polihedron/DIY-Reflow-Oven/README.md

# DIY-Reflow-Oven

Reflow Oven controler with buzzer, four reflow profiles with save and factory reset function.

https://youtu.be/2SATET4nPhk

I designed and 3D printed cover for a touch display, also I mounted mcu and other modules on a 3D printed holder.
3D files:

https://www.thingiverse.com/thing:4899782

I brought Severin TO-2068, 20L 1500W oven at second hand store.

BOM:
<ul>
<li>STM32F103 Development Board with mounting holes</li>
<li>5V 3.3V DC Logic Level Converter Bi-Directional Board Module</li>
<li>Nextion Basic 3,5" 480x320 NX4832T035</li>
<li>MAX6675 Thermocouple Module</li>
<li>Active buzzer with generator</li>
<li>5V power supply module HLK-PM01 3W</li>
<li>SSR-25DA Solid State Relay Module</li>
<li>Rocker Switch SPST, 10A/250VAC, Ø20,2mm</li>
<li>some M3 screws, wires with thermal shielding, connectors</li>
<li>Severin TO-2068 20L 1500W oven</li>
</ul>

based on awesome Vulcaman's project :
https://www.instructables.com/DIY-REFLOW-OVEN

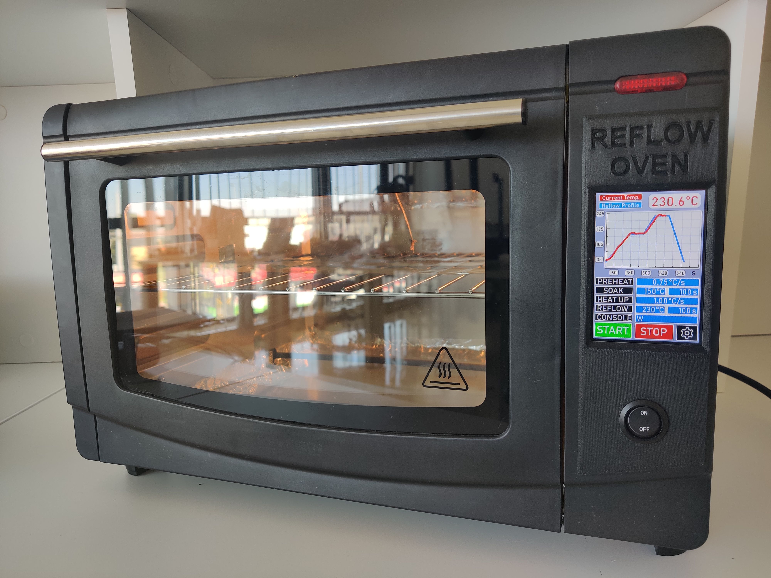
[picture p1: images/IMG_20210906_142324.jpg]


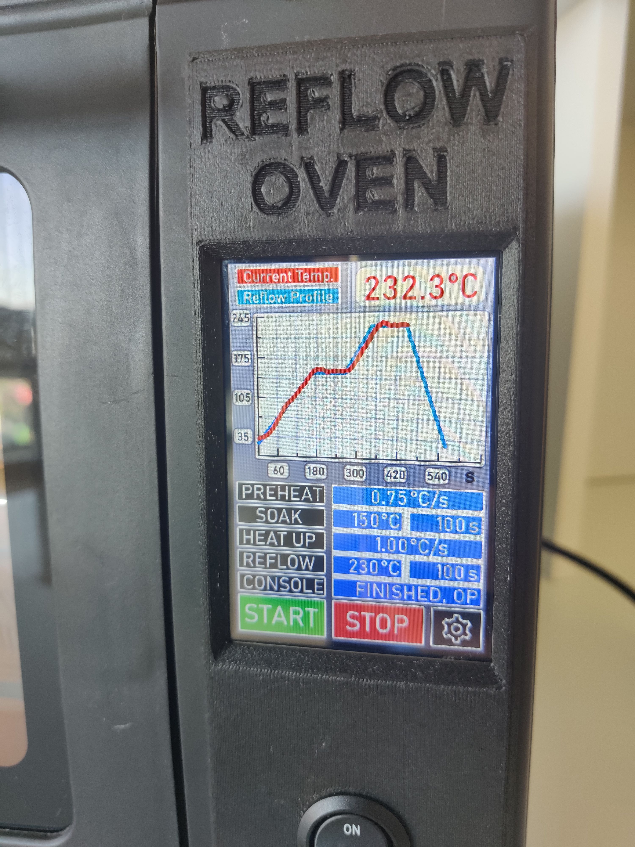
[picture p2: images/IMG_20210906_142349.jpg]


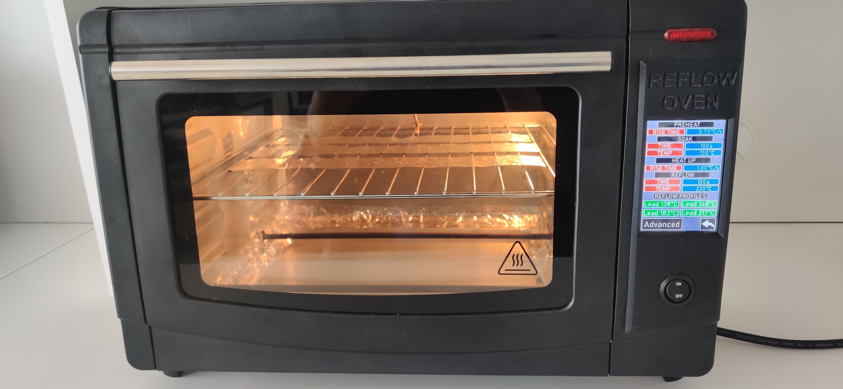
[picture p3: images/IMG_20210703_115956.jpg]






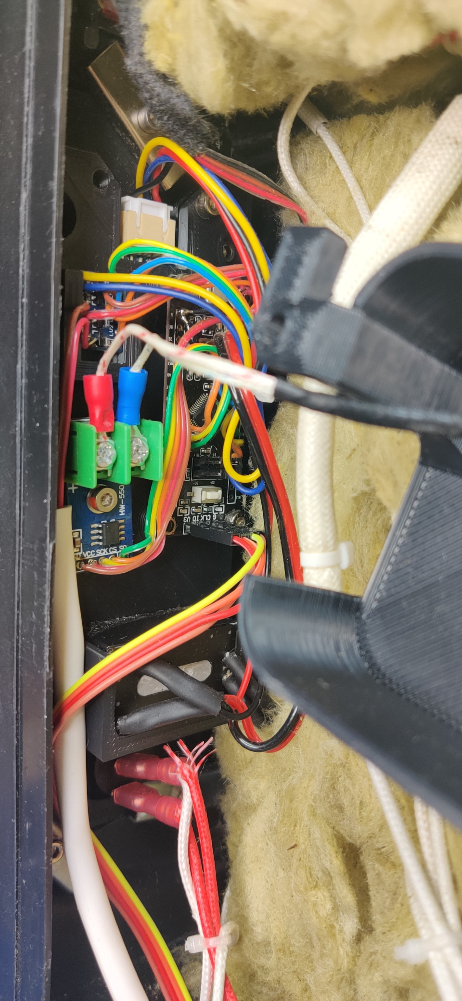
[picture p4: images/IMG_20210704_104110.jpg]


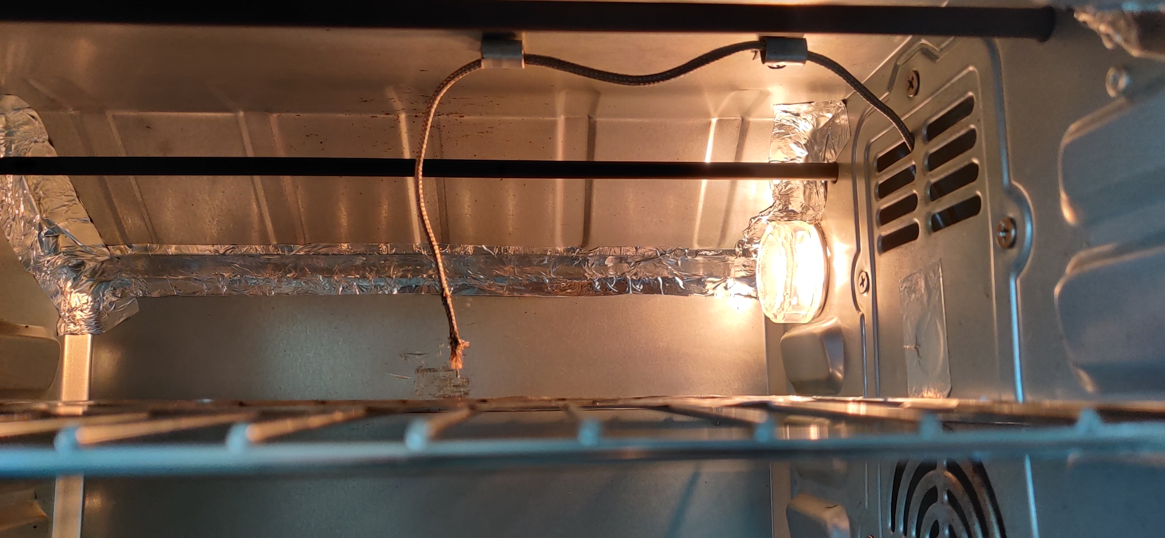
[picture p5: images/IMG_20210703_115900.jpg]


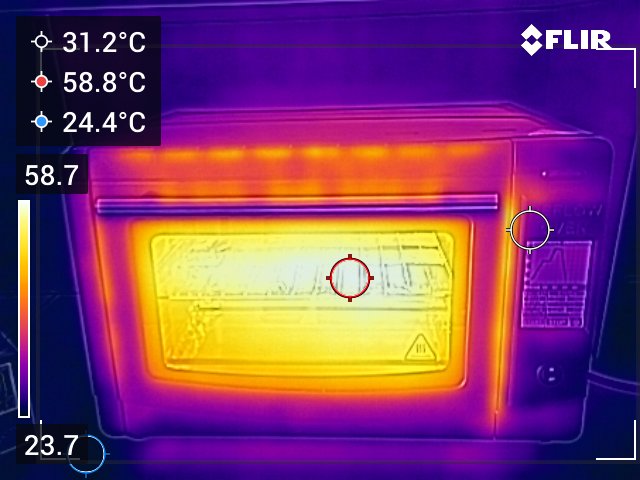
[picture p6: images/FLIR0053.jpg]
