polihedron/DIY-Reflow-Oven/nextion display/screens/0.png

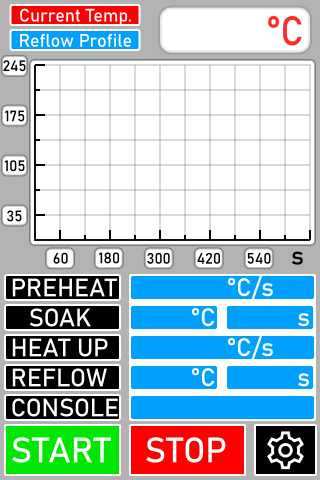
nextion display/screens/0.png
