polihedron/DIY-Reflow-Oven/nextion display/screens/1.png

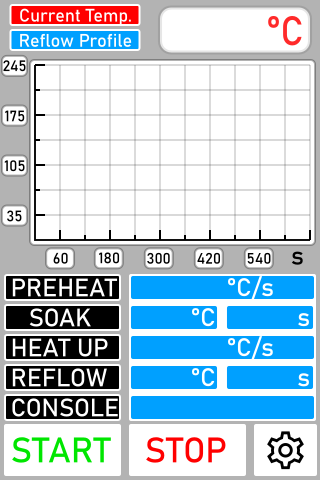
nextion display/screens/1.png
