polihedron/DIY-Reflow-Oven/nextion display/screens/2.png

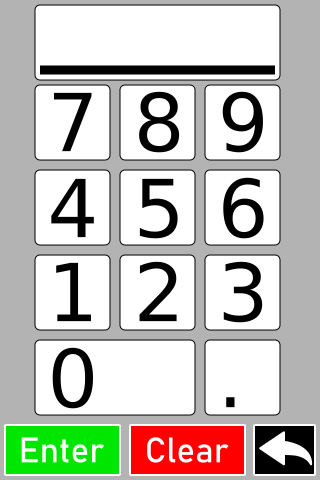
nextion display/screens/2.png
