polihedron/DIY-Reflow-Oven/nextion display/screens/3.png

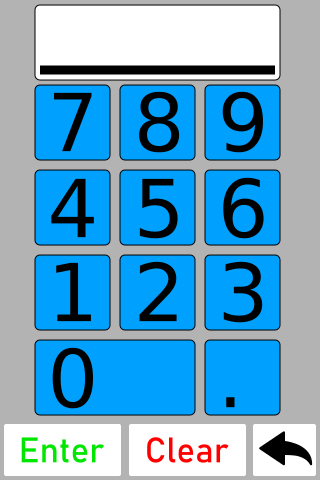
nextion display/screens/3.png
