polihedron/DIY-Reflow-Oven/nextion display/screens/4.png

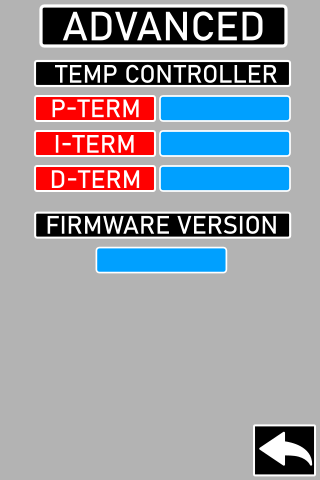
nextion display/screens/4.png
