polihedron/DIY-Reflow-Oven/nextion display/screens/5.png

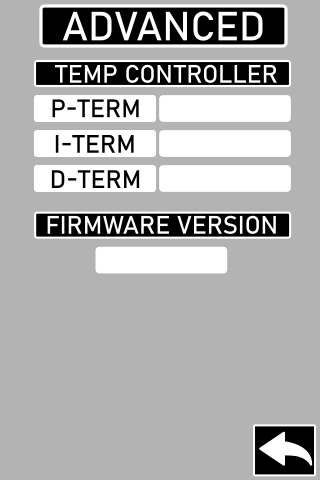
nextion display/screens/5.png
