polihedron/DIY-Reflow-Oven/nextion display/screens/6.png

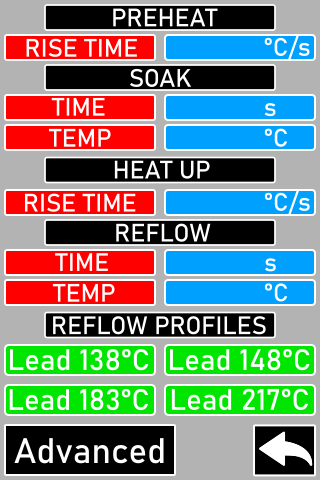
nextion display/screens/6.png
