polihedron/DIY-Reflow-Oven/nextion display/screens/7.png

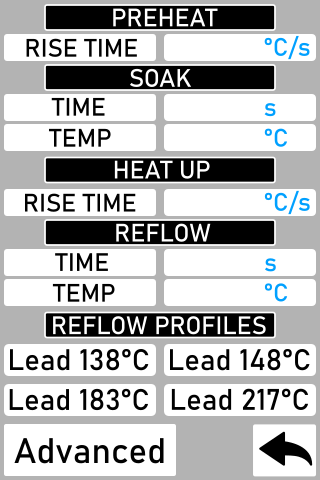
nextion display/screens/7.png
