polihedron/DIY-Reflow-Oven/(threads)

Thread 2 (2021-09-29):

On which port is connected the Buzzer ?

joelv1964, 2021-09-29:
Hi Polihedron, I have not yet started building my oven or its control electronics.  I really appreciate your idea of   adding a Buzzer, but can you tell which port of the STM32 it is connected to and if it is connected directly to it?  Thank you in advance for your answer.  Joel

polihedron, 2021-09-30:
Hi there, maybe soon I will update schematics to my mod.
Buzzer is connected via one of the 4 channel level shifter module mosfets to PA15.
But I belive it's not necessary if buzzer when active consume less than 20mA.
(Need to remove one of the resistors and cut the trace on the pcb.)
I just don't wanted to leave any mosfet useless.:)
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

joelv1964, 2021-09-30:
Great !  thank you so much.  I hadn't thought of using the second part of the shield ...
Have a good day !

daestx, 2024-08-05:
Maybe just an additional comment for The level shifter modification, when you would just like to use it as Mosfet to switch the Buzzer 5V. Here you can find a standard level shifter schematic:

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

So, in principle you need just to cut the LV connector and remove R4. LV1 pin needs to be connected

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

Closed 2021-09-30.

Thread 3 (2021-11-19):

No temperature number show up

botio, 2021-11-19:
I wired everything and flash the firmware to the blue pill and the NEXTION display, but there is not temperature number just show up empty UI... and I have tried to find out for two days... even tried another blue pill... please help me!

polihedron, 2021-11-19:
It's hard to guess,
- make sure that connections are ok,
- with USB to UART converter check that nextion can read and send data,
- the same with bluepill, connect converter to bluepill and try to send commands via terminal.
- replace level shifter module
- switch rx and tx
- etc.

botio, 2021-11-19:
Thank you so much, I found the solution is to clean the flash first and reprogram it with v1.1 bin file. Everything works fine now. next step is adding fan ... or not.

polihedron, 2021-11-20:
Adding fan can be tricky, because air temperature is quite high, easier and probably cheaper method is to look for convection oven, or find some replacement fan of the convection oven (they have metal sheet blades).

Closed 2021-11-19.

Thread 4 (2021-11-20):

how to add "reflow profiles" into 1.1 firmware

botio, 2021-11-20:
seems like only the original 1.1 firmware working for me to read the temp number, but I do really want to add the reflow profiles from "DIY-Reflow_Oven" like "lead 183" and other profiles. Could you let me know which file or which parts I should add to the 1.1 sources and build for adding this function? thank you so much.

polihedron, 2021-11-20:
This repo contains my changes, if you look closer you will find commits and changes in code of the first version 1.1.
To make mod complete you will need to flash:
- bluepill using binary version 1.2,
- nextion display with mod
recent hmi and bin files are on releases page.
If you want to build and flash from sources then just download and open project in STM32CubeIDE. Names of the folders are self-explanatory.

botio, 2021-11-20:
Hi, after tried the release 1.2 even with the bin file or the one I build from sources code, it’s not working with the mod display. The tricky part is the mod display(1.2) is only working with the original 1.1 blue pull for me. I don’t understand why and how …

polihedron, 2021-11-20:
I think you're doing something wrong. If you're using v1.2 hmi file with stm v1.1 binary, then you got chart temperature and time incorrect. Open project again in STM32CubeIDE, switch from release to debug and try to compile, then flash with full erase. It's crucial to use the same binary versions for nextion and bluepill.
Buzzer is just an output, no need to wire for the first run, especially when you're flashing blue pill stm32 with 1.1 version.
(v1.1 has no code for buzzer)

botio, 2021-11-20:
this drives me crazy... I check all the wires again, and everything is exactly like the diagram u provide... but just can't get the stm v1.2 run with mod display....

polihedron, 2021-11-20:
I have no idea why you have issues with project, already checked two stm32 bluepill boards, it's working like a charm.
Like I wrote this is quite simple mod, copy/paste code from main.c and main.h files to version 1.1, add output to PA15, or comment lines with buzzer, compile and flash, if no errors or warnings, you will get my mod version 1.2.

botio, 2021-11-21:
The only thing I think may cause problem is my levelshifter 4ch, which may not like urs. Otherwise, there is no way display can't get number from bluebill. And thank you so much for your help.

Closed 2021-11-21.

Thread 5 (2021-11-25):

Does anyone else make this working on bluepill??

botio, 2021-11-25:
okay, so I have bought the whole brand new components and did the 1.2 hmi and stm again and again. But the wired thing it's still not working (no number or profile line shows on the nextion screen) ... so I'm wondering it may not working with bluepill ... is there anyone make this working with bluepill?? thanks. BTW, the whole set is working with 1.1 original...

polihedron, 2021-11-25:
I think you should try harder. I got no problems with brand new stm32 blue pill dev board.
I was not using STM32CubeIDE, just st-link utility, and flash fw with last release bin file.
Try to debug, put some efford, check why your bluepill is not sending data to nextion display instead of opening and closing issues.

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
.

botio, 2021-11-26:
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
I tried really hard, and the reason I post this issue is to see if anyone else got the same problem like me… I’m wondering my bluepill if fake and the flash size is not real, so I order a blackpill on the way now. If opening issue bothers u, I won’t do this again just didn’t know where else I can ask. Thank u

botio, 2021-11-26:
Btw… why ur blue pill connect to the PC in the photo? Thanks

polihedron, 2021-11-26:
I'm using cheap clone bluepill.
Do you have USB to UART converter, and do you know how to use it?
You still didn't provide any more info about your issue.
Magic crystal ball is quite expensive these days, and it's hard to get one in good condition.
Like I wrote before, can you check that bluepill is working?

After power on bluepill is sending reflow profile chart data, and then constantly temperature readings together with state "IDLE", baudrate is 38400.
Remember that stm32 bluepill is using 3.3V logic, so level shifter is needed, or set usb coverter jumper to proper voltage.

To findout that Nextion display can recieve data via UART you need to connect display to UART converter, run Nextion Editor, then open v1.2 hmi file, from menu choose: Debug, switch from Send command to "Simulator", to "Nextion device", connect on your com port, and then at the Instruction Input Area as an string send:
page 3
if you done this right, and communication is working, then you should see on nextion display reflow parameters menu.
to come back to main screen send:
page 0

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

BTW nice printouts, what material did you choose?

botio, 2021-11-26:
thanks, I was watching STM32 IDE tutorial right now, since this is kinda my first STM32 project, I'm still learning. But yeah, thank you for the detail info for how to debug, and I'll going to try.

"USB to UART converter" is the st-link ?? I do have one that's how to connect to CubeIDE.

I did print out the panel with PLA .... bc I will only do reflow under 183C, is it okay? or should I print with ABS?

polihedron, 2021-11-26:
Nope, st-link isn't usb to uart converter, you should buy one, instead of buying blue pills. Try to find any on ftdi chip (ft232), but any other should work with installed drivers.
Regarding to PLA, depends on how long time will be hot oven enclosure, and how close printed parts will be.
I printed mine in ASA, but after some time decided to print in PA12 CF15, because I'm using oven quite often.

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

botio, 2021-11-26:
Uart converter, I think I found one with ft232. and after connect with bluepill to arduino via UART. I didn't see any info showed with baudrate 38400...  still trying, switch rx tx ... and going on...

polihedron, 2021-11-26:
Then there is no temperature readings, or no reflow parameters saved at start.
Flash bluepill with v1.1 fw, on the nextion display go to advanced menu where are pid settings, you can change something, but it's not mandatory, comeback to main screen.
Check btw is the temperature reading visible on the screen.
Relfow parameters should be saved now in flash memory.
Flash again bluepill with 1.2 fw, but do not erase, just flash and verify.
If still issue, then only debug left.

botio, 2021-12-05:
wait.... so u fixed it???

polihedron, 2021-12-06:
Yes, you pointed issue, I missed in code first run function witch is saving configuration parameters. If someone used old firmware version v1.1 and saved parameters to flash memory, then checked my mod flashing stm32bluepill without full memory erase - my mod was working (somehow).
So if flash memeory was erased, wihout these configuration parameters at start, stm32bluepill was unable to calculate and then send reflow curve to nextion display.
I belive that was your case, but if issue still persist, then you have hardware problem to solve, use UART to USB converter to confirm that both modules: stm32bluepill and nextion display are receiving and sending data.

My code is messy needs some general refactoring, but works.. in some circumstances ;)
Feel free to modify code and fix issues if you find any.

polihedron, 2022-07-11:
@botio did you manage make this project working?

daestx, 2024-08-11:
So, I used a bluepill board and it worked out of the box.
I compiled the code with STM32CubeIDE and flashed it with a segger j-link EDU

Closed 2022-07-18.

Thread 6 (2022-01-10):

Keypad is not reacted

VCO34, 2022-01-10:
Hello, i was testing release version 1.3, but it dont has implemented support Keypad for update profile. Is it possible ? I visited to your code and e.g. command from keypad "p1b01" is not find.  Do you have going to plan implemented ?

polihedron, 2022-01-11:
I'm not sure what you're asking for.
p1b01 is button on page 1 - keypad, for page1 is HandleKeyPad() function and that is the same as initial release.
No need to code every keypad buttton. Just the special ones like enter, or clear. Keypad is working in v1.3 just as in yt video.
To switch - update, or save reflow profile you will need p3b08 ... p3b11 buttons, saving is when you hold them for more than 3000ms, so nextion display sends commands: p3bs0 ... p2bs3.

VCO34, 2022-01-11:
Hi, problem is in release file Reflow_Oven_STM32.v1.3.bin. If i upload  file with STM32CubeProgrammer, keypad is not function. If i compile source code and upload. Keypad is fuction correct. :)

polihedron, 2022-01-12:
That's odd, both binary files: debug and release are working on my stm32 dev board.
At first run did you have blue line reflow profile, and temperature readings on the nextion display?
What stm32 dev board do you have?
Did you full erase memory before flashing?

VCO34, 2022-01-13:
Hi, first run was not problem. Temperature showed correct, by push START button started draw red line chart. I am using BluePill ARM STM32 STM32F103C8, maybe china clone. My setting CubeProbrammer - Skip flash erase before programming (OFF), Verify programming (ON), Run after programming (ON). For programing i used STlink V3 programmer.

VCO34, 2022-01-13:
Very interesting problem. If I generate RS *.bin file with my STMCubeIDE. I upload file with CubeProgrammer. Keypad is not function. If I build and upload with STMCubeIDE, keypad is function. I am sending my RS file for test for you.

https://uloz.to/tamhle/FdbzSdNu88f6/name/Nahrano-13-1-2022-v-10-29-47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

polihedron, 2022-01-16:
I think I fixed this, quite interesting case, because of compilation optimalization level: Optimalize for size -Os, and and any other than debug and none.
UART_Recieved_Flag were lost somewhere,"volatile" at the variable fixed this.

PricelessToolkit, 2022-01-16:
Thanks!!

Closed 2022-01-11.

Thread 7 (2022-04-23):

Cold junction compensation?

PricelessToolkit, 2022-04-23:
Hi @polihedron,
I want to do the same project and I have two questions if it's not difficult help me figure it out.

1. maybe you checked the whole area in the oven is heated evenly? I bought T-962A+ it does not warm up evenly, Cannot be used without full modification.
2. In the future do you have plans to implement cold junction compensation with a  1-wire temp sensor like DS18B20?
3. Thanks

polihedron, 2022-04-24:
Hi there, to be honest I didn't bother is whole area in the oven is heated evenly, because there is still quite wide temperature offset for each reflow stage in solder paste datasheet. I checked two large pcbs (171mmx131) for power leds and I'm happy with results:
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

Have you checked MAX6675 datasheet? 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

Kind Regards

polihedron, 2022-05-06:
@PricelessToolkit do you have any other questions regarding cold-junction compensation issue?

PricelessToolkit, 2022-05-06:
@polihedron No, Thank you very much for responding.

polihedron, 2022-05-07:
@PricelessToolkit ok,
good luck with project and T-962A+ mod.

Closed 2022-05-07.

Thread 8 (2022-05-22):

Limit Max Temp 240°C

PricelessToolkit, 2022-05-22:
Hi, I can't increase the temperature above 240°C, Is there a hardcoded limit in the code, or its a bug?

In my case thermocouple measuring air temperature (with this approach there is no PCB temperature overshoot )the difference between air temperature and PCB is 5-6°C and therefore wanted to raise the temperature ~10°C.

PS: my 8Liter and 800W

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

polihedron, 2022-05-22:
@PricelessToolkit
Yes, there are input limits,
look inside the HandleGui() in main.c if you want to modify them as desired.
btw. nice front panel printout.

PricelessToolkit, 2022-05-22:
Thanks i faund it
"if (Output > 240) Output = 240;"

I think 245°C is enught for me. Can you explain me how to compile this Project.  Thank you very match!!

polihedron, 2022-05-23:
@PricelessToolkit, there are many ways to compile project, look for tutorials on internet.
Easiest way is open project in STM32CubeIDE and use 'compile' button..
good luck!

PricelessToolkit, 2022-05-23:
If I succeed, I'll post the result. Thanks!!

PricelessToolkit, 2022-05-23:
all works great,  also changed the HMI file.
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
thanks for your help

Closed 2022-05-23.

Thread 9 (2022-09-24):

Temp (t0) returns zero

planestoner, 2022-09-24:
**'temp' & t0 returns/displays zero (0.0)** on Nextion display and serial logging when flashing release and debug Reflow_Oven_STM32.bin

Multiple resolutions attempted to no avail including:
- Multiple power supplies (inc PC 400w PSU) to 5V and 3.3V
- Grounding of thermocouple shield
- Connecting STM32 directly to MAX6675 module and FT232RL FTDI module
- Testing another MAX6675 module
- Testing MAX6675 module on ESP32 (confirmed as working)
- Testing separate STM32F103 module
- Confirmed genuine STM32F103 using [Blue Pill Diagnostics project](https://mecrisp-stellaris-folkdoc.sourceforge.io/bluepill-diagnostics-v1.6.html)
- Analysed SPI lines with logic analyser and Pulseview
- Debugged Reflow_Oven_STM32.bin with ST-Link V2

When testing MAX6675 module with ESP32 it shows this:
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

When testing MAX6675 module with STM32F103 with Reflow_Oven_STM32.bin it shows this:
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

When debugging Reflow_Oven_STM32.bin with ST-Link V2  'temp' reads 0.0 when setting breakpoint on main.c line 793
```
		if (ReflowEnable == 1) {
```
However, 'temp' reads correctly when setting breakpoint on main.c after line 779 (after HAL_SPI_Receive)
```
		//Thermocouple alle 500ms auslesen:
		HAL_GPIO_WritePin(CS_GPIO_Port, CS_Pin, 0);      // 778
		HAL_SPI_Receive(&hspi1, data, 2, 100);           // 779
// Breakpoint
		HAL_GPIO_WritePin(CS_GPIO_Port, CS_Pin, 1);      // 780
```

When adding ```HAL_Delay(1);``` the code runs fine (with CS being pulled low horribly long), although, this is merely a work around and not a proper fix. I tried the delay in a few placed but this seems the best location for the workaround.
```
		//Thermocouple alle 500ms auslesen:
		HAL_GPIO_WritePin(CS_GPIO_Port, CS_Pin, 0);
		HAL_SPI_Receive(&hspi1, data, 2, 100);
		HAL_Delay(1);
		HAL_GPIO_WritePin(CS_GPIO_Port, CS_Pin, 1);
```

I considered raising a PR with the added delay but STM32 documentation doesn't include it nor does the MAX6675 datasheet. I'm not entirely sure this is an issue with the code, however, raising an issue as there are no doubt better minds than mine out there with a lot more experience. Also raising this for those in the future that run into this problem. Suggested possible causes:
- External crystal is a little fast
- SPI isn't setup correctly
- Something I haven't thought of (sorry I'm not well versed in the STM32).

polihedron, 2022-09-25:
thanks @planestoner, I admire your effort,
can you check what HAL_SPI_Receive() returns?
like:
HAL_StatusTypeDef errcode;
errcode = HAL_SPI_Receive(&hspi1, data, 2, 100);

Data from logic analyser seems to be fine in both cases:
#0321 reads 1100100 = 100dec *0.249 = 24.9C
#02D1 reads 1011010 = 90dec *0.249 = 22.4C

planestoner, 2022-09-26:
Thanks @polihedron for the reply. I've tried a few things and long story short I only get a good temp reading is the the inclusion of the hal_delay.

With ``` errcode = HAL_SPI_Receive(&hspi1, data, 1, 100); ``` and without delay I get these:
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

Setting ``` HAL_SPI_Receive(&hspi1, data, 1, 100); ``` seems to pull CS low for too short a time unless I introduce the delay and I get this  (errcode returns HAL_OK):
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

polihedron, 2022-09-26:
@planestoner
maybe spi is not ready then?

this code is a bit messy, and since my oven is working I don't have time and motivation for general refactoring.
so my another idea is to use library like:
https://github.com/ipa64/MAX6675-STM32-library-using-HAL

or check this:
` while ((HAL_SPI_GetState(hspi) != HAL_SPI_STATE_READY));`
put it before spi read.

planestoner, 2022-09-26:
I'm in the same boat regarding time and since my device works with the included delay I'm happy for you to close the issue.

If the code is the issue maybe we or someone will be able to spot it and re-open this issue. In the mean time the work around is to add in the delay.

Gokhanto, 2023-06-22:
@planestoner @polihedron
Hi Guys, i havent seen the issue here, i managed to buy all the parts and assemblev all the parts and noticed that the temperature reading is stable 0.0 Degrees. Can you please help me?  Can i use your bin file with the delay to fix my issue?

polihedron, 2023-06-23:
Hi there @Gokhanto
- open reflow oven stm32 project directory in STM32CubeIDE (or simply open .project file)
- add delay in main.c like @planestoner.
- click green button Run.. and then flash your stm32 bluepill.
good luck.

Gokhanto, 2023-06-23:
@polihedron
Thanks for the quick reply. I started to open the project file but the main.c document looked like a chineese document with weird sysmbols, not much to read.  But i managed to open the main.c file by it self and added the delay, but im getting an error "Failed to connect to device., Failed to start GDB server." [https://ibb.co/fqqc4yp](url)

polihedron, 2023-06-24:
@Gokhanto I'm sorry I can't help you with this, please read or watch some tutorials on internet how to flash stm32 bluepill with st-link.

planestoner, 2023-06-25:
I've checked and sadly I don't have any of those files any more. Sorry

Gokhanto, 2023-07-10:
@planestoner @polihedron
Just for your information, i found out that the stm32, i had were a clone, so i ordered a new one and it solved all the problems, everything works.

Closed 2023-06-25.

Thread 10 (2023-03-28):

Not working.......

Cabinfourus, 2023-03-28:
I have built this thing and followed the guide with my build. I used the instructibles guide as the tutorial.
I never could get mine to work. The Nextion display has the correct screens but the STM32 code never worked at all. I loaded the .bin file correctly (i think). I am not sure how to go in and rework the source code and program the STM32. Is there a guide to this?

polihedron, 2023-03-29:
Hi there @Cabinfourus,
you're wasting your time (and mine also) with that kind of feedback: "not working...." or "never worked at all"
I can recommend you something like:
- check wiring again,
- have you tried turning off and on again?
- that's odd my is working.....

Please put some efford to figure out yours build issue, I don't have crystal ball.
No time bandwidth here and motivation to help you when you are so lazy to find and read how to debug or how to flash stm32.

Kind Regards

Closed 2023-03-29.

Thread 11 (2023-09-27):

KeyPad and Profiles not working

hellzakk, 2023-09-27:
Hi, i open the Reflow.mod.HMI project file with Nextion Editor v. 1.65.1 and I can start debugging and navigate between pages but the keypad does not work and clicking on the welding profiles does not make them visible on the first page.
I get the same result even loading the project on the display (including the non-mod / original).
Any suggestions? Thank you.

EDIT:
Button 1 Touch Release Event code is print "p1b01" but it's now deprecated [https://nextion.tech/instruction-set/](url)
Maybe the new display with updated firmware are no longer compatible with the "old" code?

polihedron, 2023-09-28:
Hi there,
- try to downgrade your nextion editor,

- use prints with "0" - all parameter, or number of chars:
`prints "p1b01",5`

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

- ask Nextion support.

hellzakk, 2023-09-28:
Hi polihedron,

i used the Nextion Editor v. 1.60.1 (with Reflow.mod.v1.3.HMI) but got the same problems (also by changing the function of the button)
Here you can see the video of the problem: 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

polihedron, 2023-09-28:
It's not an issue now.
Mcu is receiving commands and sending back strings to keypad, if you want to see input values you will have to put command in the "Instruction Input Area":
`t0.txt="1234"`
or connect dev board and check User MCU Input.

Closed 2023-09-28.

Thread 13 (2024-04-30):

How did you tune this oven?

mueti, 2024-04-30:
Hi
I have built this oven and it works so far.
But I am unable to tune the PID Controller so i does not overheat and is able to follow the curve.
I tried the CHR method but the results i got do not match the settings on the oven.
What was your method?

polihedron, 2024-05-06:
Hi there,
my method was quite easy, I used PID values from other users who build this oven in comments section Vulcans instructable. I just put them and it was working out of the box.:)
TBH I did cosmetics changes using manual PID tuning, like described on wiki:

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

in my opinion it's not easy to calibrate when you don't have build in fan, low power heaters  (below 1300W), non heat isolated chamber etc.

mueti, 2024-05-12:
Hi thanks a lot
I will try that, in school we learnd theoretically how to use the CHR method but that did not work well.

Closed 2024-05-12.

Thread 14 (2024-08-05):

Incorrect RX / TX in schematic

daestx, 2024-08-05:
I guess the RX TX line needs to be switched in the schematic:

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

RX needs to be connected with TX of the display and TX with RX.

polihedron, 2024-08-05:
Hi there,
why RX / TX lines need to be double crossed?
check RX and TX at display and level shifter:
level shifter TX5V -> Nextion RX, level shifter RX5V -> Nextion TX.

daestx, 2024-08-05:
Oh yes, you're right, on your schematic, it is crossed at the display side.  Then I take it back and you may close this ticket. Sorry about it.

Closed 2024-08-06.

Thread 15 (2024-08-11):

Slow temperature measurment

daestx, 2024-08-11:
Yesterday, I put the reflow oven into operation. In principle, the hardware works. However, my temperature measurement is causing me problems. It looks as if the temperature is strongly time-delayed. The latency then of course has an effect on the control behavior.

I suspect that this is due to my sensor. I bought the following kit with a K-sensor.

https://de.aliexpress.com/item/32985892905.html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

The sensor has a thread on its probe. I did not remove this as I was worried about damaging the sensor. However, I suspect that the latency is due to the large temperature transient, as additional material has to be heated up.

I did not see this attachment to the sensor tip in the pictures of your oven. Have you removed it? Or did you use a different K temperature sensor?

At the moment my temperature curve looks something like this:

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

My oven definitely reaches 240 °C. I don't actually think it's the PID controller. The control behavior seems to be OK.

If you'd recommend a different sensor, please add a link.

But maybe you have another idea, why I'm facing this issue.

polihedron, 2024-08-13:
Hello, I brought the same sensor,
I've extracted it from the original head for better, more accurate readings, that was quite easy with Proxxon micromot 60e.
try also lower HEAT UP parameter, 0,7C/s or 0,5C/s if you don't have build in fan.

daestx, 2024-08-13:
I'll try this. Hopefully the temperature sensor is more responsive then.

And I have exactly the same oven with the build in fan.

daestx, 2024-08-13:
I have now removed the sesor head. To do this, I simply used a side cutter and pointed pliers and cut the head open up to the crimp. The sensor can then be pulled out of the sensor head by gently wiggling the cable.

And what can I say. I wouldn't have thought that 3.34g of steel would have such an effect. In any case, the oven now works as it should. Here are a few more pictures:
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

I guess this topic can be closed.

Closed 2024-08-14.
