polihedron/DIY-Reflow-Oven/hardware/reflow.oven.mod.schematics.pdf

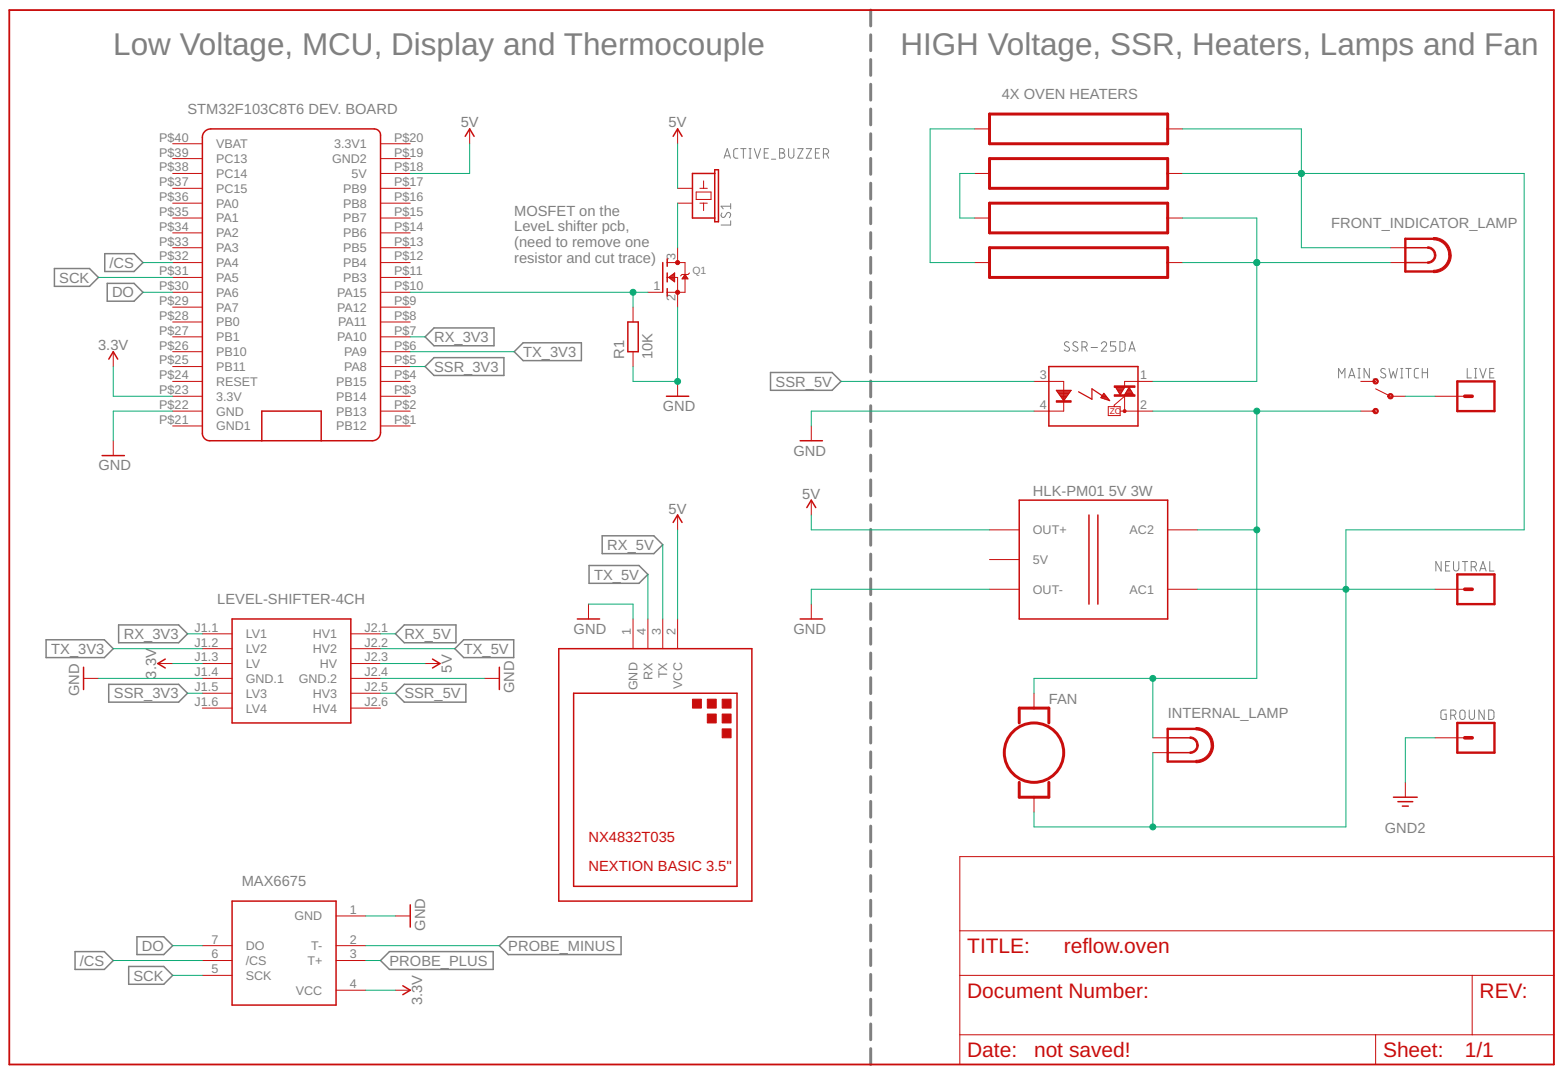
[picture p15: page 1]

MOSFET on the
LeveL shifter pcb, (need to remove one

resistor and cut trace)

Document Number: | REV:

not saved! | 1/1
