polihedron/DIY-Reflow-Oven/reflow oven stm32/Core/Src/main.c

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
/* Includes ------------------------------------------------------------------*/
#include "main.h"

/* USER CODE BEGIN Includes */
#define ARM_MATH_CM3
#include "arm_math.h"
#include "FLASH_PAGE.h"
#include "stdio.h"
#include <stdlib.h>
#include "string.h"
/* USER CODE END Includes */

SPI_HandleTypeDef hspi1;

TIM_HandleTypeDef htim1;
TIM_HandleTypeDef htim4;

UART_HandleTypeDef huart1;

void SystemClock_Config(void);
static void MX_GPIO_Init(void);
static void MX_SPI1_Init(void);
static void MX_TIM4_Init(void);
static void MX_TIM1_Init(void);
static void MX_USART1_UART_Init(void);
/* USER CODE BEGIN 0 */

#define config_version 130

typedef struct {

	float32_t KP;
	float32_t Ki;
	float32_t KD;

	float32_t firstHeatUpRate;
	uint32_t SoakTempeture;
	uint32_t SoakTime;
	float32_t secondHeatUpRate;
	uint32_t ReflowTempeture;
	uint32_t ReflowTime;

	float32_t firstHeatUpRate0;
	uint32_t SoakTempeture0;
	uint32_t SoakTime0;
	float32_t secondHeatUpRate0;
	uint32_t ReflowTempeture0;
	uint32_t ReflowTime0;

	float32_t firstHeatUpRate1;
	uint32_t SoakTempeture1;
	uint32_t SoakTime1;
	float32_t secondHeatUpRate1;
	uint32_t ReflowTempeture1;
	uint32_t ReflowTime1;

	float32_t firstHeatUpRate2;
	uint32_t SoakTempeture2;
	uint32_t SoakTime2;
	float32_t secondHeatUpRate2;
	uint32_t ReflowTempeture2;
	uint32_t ReflowTime2;

	float32_t firstHeatUpRate3;
	uint32_t SoakTempeture3;
	uint32_t SoakTime3;
	float32_t secondHeatUpRate3;
	uint32_t ReflowTempeture3;
	uint32_t ReflowTime3;

	uint32_t version;

}	config;


uint32_t TimerBUZZER;
uint32_t TimerGui;
uint8_t beep;
uint8_t data[2];
uint8_t ReflowCurve[4000];
float temp;
float lastTemp;
float duty;

arm_pid_instance_f32 PID;
config ReflowParameters;

uint8_t ReflowEnable = 0;
uint8_t BuzzerEnable = 0;
uint16_t ReflowIndex = 0;

float32_t debug = 0;
uint8_t Cmd_End[3] = {0xFF, 0xFF, 0xFF};
uint8_t UART_Recieved_Data[5]={'p','0','x','x','x'};
volatile uint8_t UART_Recieved_Flag = 0;

char input[20];
uint16_t PhaseIndex[5]={0};

char ConsoleMSG[25];

uint8_t TempDrawEnable = 0;
uint32_t TempDrawCounter = 0;



void SaveReflowParameters(){
	Flash_Write_Data(0x0801FC00, (uint32_t *)&ReflowParameters, 34);
}


void HAL_UART_RxCpltCallback(UART_HandleTypeDef *huart){
	HAL_UART_Receive_IT(&huart1, UART_Recieved_Data, 5);
	UART_Recieved_Flag =1;
}


void NEXTION_SendString (char *ID, char *string){
	char buf[50];
	int len = sprintf(buf, "%s.txt=\"%s\"", ID, string);
	HAL_UART_Transmit(&huart1, (uint8_t *)buf, len, 1000);
	HAL_UART_Transmit(&huart1, Cmd_End, 3, 100);

}


void NEXTION_SendFloat (char *ID, float32_t number){
	char buf[50];
	int len = sprintf(buf, "%s.txt=\"%.2f\"", ID, number);
	HAL_UART_Transmit(&huart1, (uint8_t *)buf, len, 1000);
	HAL_UART_Transmit(&huart1, Cmd_End, 3, 100);
}

void NEXTION_SendFloat_CurrentTemp (char *ID, float32_t number){
	char buf[50];
	int len = sprintf(buf, "%s.txt=\"%.1f\"", ID, number);
	HAL_UART_Transmit(&huart1, (uint8_t *)buf, len, 1000);
	HAL_UART_Transmit(&huart1, Cmd_End, 3, 100);
}


void NEXTION_SenduInt (char *ID, uint32_t number){
	char buf[50];
	int len = sprintf(buf, "%s.txt=\"%lu\"", ID, number);
	HAL_UART_Transmit(&huart1, (uint8_t *)buf, len, 1000);
	HAL_UART_Transmit(&huart1, Cmd_End, 3, 100);
}


void NEXTION_CMD (char *string){
	HAL_UART_Transmit(&huart1, (uint8_t *)string, strlen(string), 1000);
	HAL_UART_Transmit(&huart1, Cmd_End, 3, 100);
}


void UpdatePage(){
	NEXTION_SendFloat("t1",ReflowParameters.firstHeatUpRate);
	NEXTION_SenduInt("t2", ReflowParameters.SoakTempeture);
	NEXTION_SenduInt("t3", ReflowParameters.SoakTime);
	NEXTION_SendFloat("t4",ReflowParameters.secondHeatUpRate);
	NEXTION_SenduInt("t5", ReflowParameters.ReflowTempeture);
	NEXTION_SenduInt("t6", ReflowParameters.ReflowTime);
}


void NextionDrawDot(uint32_t x, uint32_t y){

	char buf[50];
	int len = sprintf(buf, "cirs %lu,%lu,2,1311", x, y);	//RGB888: 0.160.255 RGB565:1311
	HAL_UART_Transmit(&huart1, (uint8_t *)buf, len, 1000);
	HAL_UART_Transmit(&huart1, Cmd_End, 3, 100);
}


void NextionDrawTemp(uint32_t x, uint32_t y){

	char buf[50];
	int len = sprintf(buf, "cirs %lu,%lu,2,RED", x, y);
	HAL_UART_Transmit(&huart1, (uint8_t *)buf, len, 1000);
	HAL_UART_Transmit(&huart1, Cmd_End, 3, 100);
}

float32_t HandleKeyPad() {

	//clear Input
	for (int i = 0; i < 20; i++) {
		input[i] = 0;
	}

	uint8_t index = 0;

	NEXTION_SendString("t0", "");
	UART_Recieved_Flag = 0;

	while (strncmp((char*) UART_Recieved_Data, "enter", 5) != 0) {

		if(strncmp((char*) UART_Recieved_Data, "abbre", 5) == 0)
				return 9999;
		if(strncmp((char*) UART_Recieved_Data, "kback", 5) == 0)
				return 8888;

		if (UART_Recieved_Flag == 1) {
			input[index] = UART_Recieved_Data[4];
			UART_Recieved_Flag = 0;
			index++;
			NEXTION_SendString("t0", input);
		}
	}
	return atof(input);
}


void Update_Page_3() {
	uint8_t defaultUart[5] = {'p','3','x','x','x'};
	for(int i=0;i<5;i++){
		UART_Recieved_Data[i]=defaultUart[i];
	}

	NEXTION_SendFloat("t0", ReflowParameters.firstHeatUpRate);
	NEXTION_SenduInt("t1", ReflowParameters.SoakTime);
	NEXTION_SenduInt("t2", ReflowParameters.SoakTempeture);
	NEXTION_SendFloat("t3", ReflowParameters.secondHeatUpRate);
	NEXTION_SenduInt("t4", ReflowParameters.ReflowTime);
	NEXTION_SenduInt("t5", ReflowParameters.ReflowTempeture);

}


void Update_Page_0() {
	uint8_t defaultUart[5] = {'p','0','x','x','x'};
	for(int i=0;i<5;i++)	{
		UART_Recieved_Data[i]=defaultUart[i];
	}

	float32_t dx = 0.20833; //275px / 660s / 500 ms
	float32_t dy = 0.7143; //175px / 245 Grad
	uint32_t OffsetX = 35;
	uint32_t OffsetY = 240;

		//Reflow Aktuelle Temperatur anzeigen:
		if (ReflowEnable == 1)	{
			TempDrawEnable = 1;

		}

		if(TempDrawEnable == 1){
			NextionDrawTemp(OffsetX + (uint32_t)((float32_t)(TempDrawCounter)*dx), OffsetY - (uint32_t)((float32_t)(temp)*dy));

		if(ReflowCurve[TempDrawCounter] == 0 ){
			TempDrawEnable = 0;
		}


		}

	NEXTION_SendFloat_CurrentTemp("t0", temp);
	NEXTION_SendFloat("t1", ReflowParameters.firstHeatUpRate);
	NEXTION_SenduInt("t3", ReflowParameters.SoakTime);
	NEXTION_SenduInt("t2", ReflowParameters.SoakTempeture);
	NEXTION_SendFloat("t4", ReflowParameters.secondHeatUpRate);
	NEXTION_SenduInt("t6", ReflowParameters.ReflowTime);
	NEXTION_SenduInt("t5", ReflowParameters.ReflowTempeture);
	NEXTION_SendString("g1", ConsoleMSG);

}


void Update_Page_2() {
	uint8_t defaultUart[5] = {'p','2','x','x','x'};
	for(int i=0;i<5;i++){
		UART_Recieved_Data[i]=defaultUart[i];
	}

	NEXTION_SendFloat("t0", ReflowParameters.KP);
	NEXTION_SendFloat("t1", ReflowParameters.Ki);
	NEXTION_SendFloat("t2", ReflowParameters.KD);
	NEXTION_SendFloat("t3", (float32_t) ReflowParameters.version/100);
}


void HandleGui(){
	//###################Page0##########################

	if(strncmp((char *)UART_Recieved_Data, "p0xxx", 5) == 0){
			Update_Page_0();
			}

	if(strncmp((char *)UART_Recieved_Data, "p0b02", 5) == 0){
			Update_Page_3();
			}

	if(strncmp((char *)UART_Recieved_Data, "p0b00", 5) == 0){
			startReflow();
			Update_Page_0();
			}

	if(strncmp((char *)UART_Recieved_Data, "p0b01", 5) == 0){
			stopReflow();
			  // buzzer beeps at the FINISHED cycle until STOP button pressed
			  if (BuzzerEnable == 1)	{
				  BuzzerEnable = 0;
			  }
			Update_Page_0();
			}

	if(strncmp((char *)UART_Recieved_Data, "p0b02", 5) == 0){
			Update_Page_3();
			}

	//###################Page2##########################

	  if(strncmp((char *)UART_Recieved_Data, "p2xxx", 5) == 0){
		Update_Page_2();
		}

		  if(strncmp((char *)UART_Recieved_Data, "p2b00", 5) == 0){
			  float32_t Output =0;
			  Output = HandleKeyPad();
			  while(Output == 9999){
					uint8_t defaultUart[5] = {'x','x','x','x','x'};
					for(int i=0;i<5;i++){
						UART_Recieved_Data[i]=defaultUart[i];
					}
				  Output = HandleKeyPad();
			  }
			  if(Output == 8888){
				 Output = ReflowParameters.KP;
			  }

	    ReflowParameters.KP = Output;
	    PID.Kp = ReflowParameters.KP;
		arm_pid_init_f32(&PID, 1);
		Update_Page_2();
		NEXTION_CMD("page 2");

		}

		  if(strncmp((char *)UART_Recieved_Data, "p2b01", 5) == 0){
			  float32_t Output =0;
			  Output = HandleKeyPad();
			  while(Output == 9999){
					uint8_t defaultUart[5] = {'x','x','x','x','x'};
					for(int i=0;i<5;i++){
						UART_Recieved_Data[i]=defaultUart[i];
					}
				  Output = HandleKeyPad();
			  }
			  if(Output == 8888){
				 Output = ReflowParameters.Ki;
			  }
			  ReflowParameters.Ki = Output;
			  	    PID.Ki = ReflowParameters.Ki;
			arm_pid_init_f32(&PID, 1);
			Update_Page_2();
			NEXTION_CMD("page 2");

		}

		  if(strncmp((char *)UART_Recieved_Data, "p2b02", 5) == 0){
			  float32_t Output =0;
			  Output = HandleKeyPad();
			  while(Output == 9999){
					uint8_t defaultUart[5] = {'x','x','x','x','x'};
					for(int i=0;i<5;i++){
						UART_Recieved_Data[i]=defaultUart[i];
					}
				  Output = HandleKeyPad();
			  }
			  if(Output == 8888){
				 Output = ReflowParameters.KD;
			  }
			  ReflowParameters.KD = Output;
			 			  	    PID.Kd = ReflowParameters.KD;
			arm_pid_init_f32(&PID, 1);
			Update_Page_2();
			NEXTION_CMD("page 2");

		}

		  if(strncmp((char *)UART_Recieved_Data, "p2b03", 5) == 0){
			Update_Page_3();
			SaveReflowParameters();
		}


	//###################Page 3########################

	  if(strncmp((char *)UART_Recieved_Data, "p3xxx", 5) == 0){
		Update_Page_3();
		}

		  if(strncmp((char *)UART_Recieved_Data, "p3b00", 5) == 0){
			  float32_t Output =0;
			  Output = HandleKeyPad();
			  while(Output == 9999){
					uint8_t defaultUart[5] = {'x','x','x','x','x'};
					for(int i=0;i<5;i++){
						UART_Recieved_Data[i]=defaultUart[i];
					}
				  Output = HandleKeyPad();
			  }
			  if(Output == 8888){
				 Output = ReflowParameters.firstHeatUpRate;
			  }

			  if (Output < 0.2)
				  Output = 0.2;
			  if (Output > 1.5)
				  Output = 1.5;

		ReflowParameters.firstHeatUpRate = Output;
		Update_Page_3();
		NEXTION_CMD("page 3");
		calculateReflowCurve();

		}
		//NEXTION_SendFloat("t0", ReflowParameters.firstHeatUpRate);

		  if(strncmp((char *)UART_Recieved_Data, "p3b01", 5) == 0){
			  float32_t Output =0;
			  Output = HandleKeyPad();
			  while(Output == 9999){
					uint8_t defaultUart[5] = {'x','x','x','x','x'};
					for(int i=0;i<5;i++){
						UART_Recieved_Data[i]=defaultUart[i];
					}
				  Output = HandleKeyPad();
			  }
			  if(Output == 8888){
				 Output = ReflowParameters.SoakTime;
			  }

			  if (Output > 300)
				  Output = 300;

			ReflowParameters.SoakTime = Output;
			Update_Page_3();
			NEXTION_CMD("page 3");
			calculateReflowCurve();

		}
		//NEXTION_SendFloat("t0", ReflowParameters.firstHeatUpRate);

		  if(strncmp((char *)UART_Recieved_Data, "p3b02", 5) == 0){
			  float32_t Output =0;
			  Output = HandleKeyPad();
			  while(Output == 9999){
					uint8_t defaultUart[5] = {'x','x','x','x','x'};
					for(int i=0;i<5;i++){
						UART_Recieved_Data[i]=defaultUart[i];
					}
				  Output = HandleKeyPad();
			  }
			  if(Output == 8888){
				 Output = ReflowParameters.SoakTempeture;
			  }

			  if (Output < 30)
				  Output = 30;
			  if (Output > 240)
				  Output = 240;

			ReflowParameters.SoakTempeture = Output;
			Update_Page_3();
			NEXTION_CMD("page 3");
			calculateReflowCurve();

		}
		//NEXTION_SendFloat("t0", ReflowParameters.firstHeatUpRate);

		  if(strncmp((char *)UART_Recieved_Data, "p3b03", 5) == 0){
			  float32_t Output =0;
			  Output = HandleKeyPad();
			  while(Output == 9999){
					uint8_t defaultUart[5] = {'x','x','x','x','x'};
					for(int i=0;i<5;i++){
						UART_Recieved_Data[i]=defaultUart[i];
					}
				  Output = HandleKeyPad();
			  }
			  if(Output == 8888){
				 Output = ReflowParameters.secondHeatUpRate;
			  }

			  if (Output < 0.2)
				  Output = 0.2;
			  if (Output > 1.5)
				  Output = 1.5;

			ReflowParameters.secondHeatUpRate = Output;
			Update_Page_3();
			NEXTION_CMD("page 3");
			calculateReflowCurve();

		}


		//NEXTION_SendFloat("t0", ReflowParameters.firstHeatUpRate);

		  if(strncmp((char *)UART_Recieved_Data, "p3b04", 5) == 0){
			  float32_t Output =0;
			  Output = HandleKeyPad();
			  while(Output == 9999){
					uint8_t defaultUart[5] = {'x','x','x','x','x'};
					for(int i=0;i<5;i++){
						UART_Recieved_Data[i]=defaultUart[i];
					}
				  Output = HandleKeyPad();
			  }
			  if(Output == 8888){
				 Output = ReflowParameters.ReflowTime;
			  }

			  if (Output > 300)
				  Output = 300;

			ReflowParameters.ReflowTime = Output;
			Update_Page_3();
			NEXTION_CMD("page 3");
			calculateReflowCurve();

		}
		//NEXTION_SendFloat("t0", ReflowParameters.firstHeatUpRate);

		  if(strncmp((char *)UART_Recieved_Data, "p3b05", 5) == 0){
			  float32_t Output =0;
			  Output = HandleKeyPad();
			  while(Output == 9999){
					uint8_t defaultUart[5] = {'x','x','x','x','x'};
					for(int i=0;i<5;i++){
						UART_Recieved_Data[i]=defaultUart[i];
					}
				  Output = HandleKeyPad();
			  }
			  if(Output == 8888){
				 Output = ReflowParameters.ReflowTempeture;
			  }
			  if (Output < 30)
				  Output = 30;
			  if (Output > 240)
				  Output = 240;
			ReflowParameters.ReflowTempeture = Output;
			Update_Page_3();
			NEXTION_CMD("page 3");
			calculateReflowCurve();

		}

		  if(strncmp((char *)UART_Recieved_Data, "p3b06", 5) == 0){
			Update_Page_2();
		}


		  if(strncmp((char *)UART_Recieved_Data, "p3b07", 5) == 0){
			Update_Page_0();
			Draw_Reflow_Curve();
			SaveReflowParameters();

		}


		  	// Save current parameters to Lead 138C profile
		  if(strncmp((char *)UART_Recieved_Data, "p3bs0", 5) == 0){

			  ReflowParameters.firstHeatUpRate0 = ReflowParameters.firstHeatUpRate;
			  ReflowParameters.SoakTime0 = ReflowParameters.SoakTime;
			  ReflowParameters.SoakTempeture0 = ReflowParameters.SoakTempeture;
			  ReflowParameters.secondHeatUpRate0 = ReflowParameters.secondHeatUpRate;
			  ReflowParameters.ReflowTime0 = ReflowParameters.ReflowTime;
			  ReflowParameters.ReflowTempeture0 = ReflowParameters.ReflowTempeture;
			  Update_Page_3();
			  // needed page refresh because of strange nextion timers behavior
			  NEXTION_CMD("page 3");
			  calculateReflowCurve();

		  }

			 // Load Lead 138C profile
		  if(strncmp((char *)UART_Recieved_Data, "p3b08", 5) == 0){

			  ReflowParameters.firstHeatUpRate = ReflowParameters.firstHeatUpRate0;
			  ReflowParameters.SoakTime = ReflowParameters.SoakTime0;
			  ReflowParameters.SoakTempeture = ReflowParameters.SoakTempeture0;
			  ReflowParameters.secondHeatUpRate = ReflowParameters.secondHeatUpRate0;
			  ReflowParameters.ReflowTime = ReflowParameters.ReflowTime0;
			  ReflowParameters.ReflowTempeture = ReflowParameters.ReflowTempeture0;
			  Update_Page_3();
			  //NEXTION_CMD("page 3");
			  calculateReflowCurve();
		  }

		  	// Save current parameters to Lead 148C profile
		  if(strncmp((char *)UART_Recieved_Data, "p3bs1", 5) == 0){
			  ReflowParameters.firstHeatUpRate1 = ReflowParameters.firstHeatUpRate;
			  ReflowParameters.SoakTime1 = ReflowParameters.SoakTime;
			  ReflowParameters.SoakTempeture1 = ReflowParameters.SoakTempeture;
			  ReflowParameters.secondHeatUpRate1 = ReflowParameters.secondHeatUpRate;
			  ReflowParameters.ReflowTime1 = ReflowParameters.ReflowTime;
			  ReflowParameters.ReflowTempeture1 = ReflowParameters.ReflowTempeture;
			  Update_Page_3();
			  // needed page refresh because of strange nextion timers behavior
			  NEXTION_CMD("page 3");
			  calculateReflowCurve();
		  }

			 // Load Lead 148C profile
		  if(strncmp((char *)UART_Recieved_Data, "p3b09", 5) == 0){

			  ReflowParameters.firstHeatUpRate = ReflowParameters.firstHeatUpRate1;
			  ReflowParameters.SoakTime = ReflowParameters.SoakTime1;
			  ReflowParameters.SoakTempeture = ReflowParameters.SoakTempeture1;
			  ReflowParameters.secondHeatUpRate = ReflowParameters.secondHeatUpRate1;
			  ReflowParameters.ReflowTime = ReflowParameters.ReflowTime1;
			  ReflowParameters.ReflowTempeture = ReflowParameters.ReflowTempeture1;
			  Update_Page_3();
			  //NEXTION_CMD("page 3");
			  calculateReflowCurve();
		  }

		  	// Save current parameters to Lead 183C profile
		  if(strncmp((char *)UART_Recieved_Data, "p3bs2", 5) == 0){
			  ReflowParameters.firstHeatUpRate2 = ReflowParameters.firstHeatUpRate;
			  ReflowParameters.SoakTime2 = ReflowParameters.SoakTime;
			  ReflowParameters.SoakTempeture2 = ReflowParameters.SoakTempeture;
			  ReflowParameters.secondHeatUpRate2 = ReflowParameters.secondHeatUpRate;
			  ReflowParameters.ReflowTime2 = ReflowParameters.ReflowTime;
			  ReflowParameters.ReflowTempeture2 = ReflowParameters.ReflowTempeture;
			  Update_Page_3();
			  // needed page refresh because of strange nextion timers behavior
			  NEXTION_CMD("page 3");
			  calculateReflowCurve();
		  }

			 // Load Lead 183C profile
		  if(strncmp((char *)UART_Recieved_Data, "p3b10", 5) == 0){

			  ReflowParameters.firstHeatUpRate = ReflowParameters.firstHeatUpRate2;
			  ReflowParameters.SoakTime = ReflowParameters.SoakTime2;
			  ReflowParameters.SoakTempeture = ReflowParameters.SoakTempeture2;
			  ReflowParameters.secondHeatUpRate = ReflowParameters.secondHeatUpRate2;
			  ReflowParameters.ReflowTime = ReflowParameters.ReflowTime2;
			  ReflowParameters.ReflowTempeture = ReflowParameters.ReflowTempeture2;
			  Update_Page_3();
			  //NEXTION_CMD("page 3");
			  calculateReflowCurve();
		  }

		  	// Save current parameters to Lead 217C profile
		  if(strncmp((char *)UART_Recieved_Data, "p3bs3", 5) == 0){
			  ReflowParameters.firstHeatUpRate3 = ReflowParameters.firstHeatUpRate;
			  ReflowParameters.SoakTime3 = ReflowParameters.SoakTime;
			  ReflowParameters.SoakTempeture3 = ReflowParameters.SoakTempeture;
			  ReflowParameters.secondHeatUpRate3 = ReflowParameters.secondHeatUpRate;
			  ReflowParameters.ReflowTime3 = ReflowParameters.ReflowTime;
			  ReflowParameters.ReflowTempeture3 = ReflowParameters.ReflowTempeture;
			  Update_Page_3();
			  // needed page refresh because of strange nextion timers behavior
			  NEXTION_CMD("page 3");
			  calculateReflowCurve();
		  }

		  	// Load Lead 217C profile
		  if(strncmp((char *)UART_Recieved_Data, "p3b11", 5) == 0){

			  ReflowParameters.firstHeatUpRate = ReflowParameters.firstHeatUpRate3;
			  ReflowParameters.SoakTime = ReflowParameters.SoakTime3;
			  ReflowParameters.SoakTempeture = ReflowParameters.SoakTempeture3;
			  ReflowParameters.secondHeatUpRate = ReflowParameters.secondHeatUpRate3;
			  ReflowParameters.ReflowTime = ReflowParameters.ReflowTime3;
			  ReflowParameters.ReflowTempeture = ReflowParameters.ReflowTempeture3;
			  Update_Page_3();
			  //NEXTION_CMD("page 3");
			  calculateReflowCurve();
		  }

		  // restore factory default profiles	(not all tested)
		  if(strncmp((char *)UART_Recieved_Data, "p3br7", 5) == 0){

			  	// Lead 217C https://www.chipquik.com/datasheets/TS391SNL50.pdf
				ReflowParameters.firstHeatUpRate3 = 0.75;
				ReflowParameters.SoakTime3 = 100;
				ReflowParameters.SoakTempeture3 = 175;
				ReflowParameters.secondHeatUpRate3 = 1;
				ReflowParameters.ReflowTime3 = 90;
				ReflowParameters.ReflowTempeture3 = 240;
				// Lead 183C https://www.chipquik.com/datasheets/TS391AX50.pdf
				ReflowParameters.firstHeatUpRate2 = 0.75;
				ReflowParameters.SoakTime2 = 100;
				ReflowParameters.SoakTempeture2 = 150;
				ReflowParameters.secondHeatUpRate2 = 1;
				ReflowParameters.ReflowTime2 = 100;
				ReflowParameters.ReflowTempeture2 = 230;
				// Lead 148C
				ReflowParameters.firstHeatUpRate1 = 0.75;
				ReflowParameters.SoakTime1 = 100;
				ReflowParameters.SoakTempeture1 = 140;
				ReflowParameters.secondHeatUpRate1 = 1;
				ReflowParameters.ReflowTime1 = 100;
				ReflowParameters.ReflowTempeture1 = 175;
				// Lead 138C http://www.chipquik.com/datasheets/TS391LT50.pdf
				ReflowParameters.firstHeatUpRate0 = 0.75;
				ReflowParameters.SoakTime0 = 100;
				ReflowParameters.SoakTempeture0 = 130;
				ReflowParameters.secondHeatUpRate0 = 1;
				ReflowParameters.ReflowTime0 = 100;
				ReflowParameters.ReflowTempeture0 = 165;
				// Lead default (138C)
				ReflowParameters.firstHeatUpRate = 0.75;
				ReflowParameters.SoakTime = 100;
				ReflowParameters.SoakTempeture = 130;
				ReflowParameters.secondHeatUpRate = 1;
				ReflowParameters.ReflowTime = 100;
				ReflowParameters.ReflowTempeture = 165;

				calculateReflowCurve();
				Update_Page_0();
		  }

}




void HAL_TIM_PeriodElapsedCallback(TIM_HandleTypeDef *htim) {

	TempDrawCounter++;

	if (htim == &htim4) {
		//Thermocouple alle 500ms auslesen:
		HAL_GPIO_WritePin(CS_GPIO_Port, CS_Pin, 0);
		HAL_SPI_Receive(&hspi1, data, 2, 100);
		HAL_GPIO_WritePin(CS_GPIO_Port, CS_Pin, 1);

		temp = ((((uint16_t) data[1] << 8) | data[0]) >> 3) * 0.249;
		// basic filter to reduce random and noisy temperature readings
		if ((fabs(temp - lastTemp) > 25) && (HAL_GetTick() > 3000))	{
			temp = lastTemp;
		}
		else {
			lastTemp=temp;
		}

		//Reflow Prozess Einleiten:
		if (ReflowEnable == 1) {
			//NextionDrawTemp(OffsetX + (uint32_t)((float32_t)(ReflowIndex)*dx), OffsetY - (uint32_t)((float32_t)(temp)*dy));

			if(ReflowIndex == PhaseIndex[0])
				sprintf(ConsoleMSG,"PREHEAT");
			if(ReflowIndex == PhaseIndex[1])
				sprintf(ConsoleMSG,"SOAK");
			if(ReflowIndex == PhaseIndex[2])
				sprintf(ConsoleMSG,"HEAT UP");
			if(ReflowIndex == PhaseIndex[3])
				sprintf(ConsoleMSG,"REFLOW");

			//Regelabweichung
			float pid_error =  ReflowCurve[ReflowIndex] - temp;
			//Stellgroesse
			duty =  arm_pid_f32(&PID, pid_error);

			//Stellgrößenbegrenzung und Anti-Wind-UP (update 27.03.2021)
			if (duty > 1000) {
				duty = 1000;
				PID.Ki = 0;
			} else if (duty < 0) {
				duty = 0;
			}
			else{
				PID.Ki = ReflowParameters.Ki;
			}

			//Dutycycle Anpassen
			htim1.Instance->CCR1 = (uint16_t)duty;

			ReflowIndex++;
			//Abbruchbedingung
			if (ReflowIndex == PhaseIndex[4]) {
				sprintf(ConsoleMSG,"FINISHED, OPEN DOOR");
					BuzzerEnable = 1;
					ReflowEnable = 0;
			}

		} else {
			ReflowIndex = 0;
			//Dutycycle = 0
			htim1.Instance->CCR1 = 0;
		}

	}

}


void calculateReflowCurve(){
	for(int i =0;i<4000;i++){
		ReflowCurve[i]=0;
	}

	int index = 0;
	float timestep = 0.5;
	//First Heat Up:
	while (24 + timestep * ReflowParameters.firstHeatUpRate <= ReflowParameters.SoakTempeture) {
	ReflowCurve[index] = 24 + timestep * ReflowParameters.firstHeatUpRate;
	index++;
	timestep = timestep + 0.5;
	}
	PhaseIndex[1]=index;

	//Soak
	int Soakduration = 2*ReflowParameters.SoakTime;

	for(int i=0;i<Soakduration;i++){
		ReflowCurve[index+i]=ReflowParameters.SoakTempeture;
	}

	//Second Heat Up:
	index = index + Soakduration;
	PhaseIndex[2]=index;
	timestep = 0.5;
	while (ReflowParameters.SoakTempeture + timestep * ReflowParameters.secondHeatUpRate <= ReflowParameters.ReflowTempeture) {
	ReflowCurve[index] = ReflowParameters.SoakTempeture + (uint8_t)timestep * ReflowParameters.secondHeatUpRate;
	index++;
	timestep = timestep + 0.5;
	}
	PhaseIndex[3]=index;

	//Reflow
	int Reflowduration = 2*ReflowParameters.ReflowTime;

	for(int i=0;i<Reflowduration;i++){
		ReflowCurve[index+i]=ReflowParameters.ReflowTempeture;
	}

	index = index + Reflowduration;
	ReflowCurve[index]=0;
	PhaseIndex[4]=index;

	//Cooldown
	timestep = 0.5;
	while (ReflowParameters.ReflowTempeture - timestep * 1.8 >= 24) {
	ReflowCurve[index] = ReflowParameters.ReflowTempeture - timestep * 1.8;
	index++;
	timestep = timestep + 0.5;

	}
}


void Draw_Reflow_Curve()	{
	float32_t dx = 0.20833; //275px / 660s / 500 ms
	float32_t dy = 0.7143; //175px / 245 Grad
	uint32_t OffsetX = 35;
	uint32_t OffsetY = 240;
	uint32_t index = 0;

	while(ReflowCurve[index] != 0){

		NextionDrawDot(OffsetX + (uint32_t)((float32_t)(index)*dx), OffsetY - (uint32_t)((float32_t)(ReflowCurve[index])*dy));
		index= index + 4;

		if(strncmp((char *)UART_Recieved_Data, "p0b02", 5) == 0)
			break;
	}
}


void startReflow()	{
	ReflowEnable = 1;
	NEXTION_CMD("page 0");
	Draw_Reflow_Curve();
	TempDrawCounter = 0;
	Update_Page_0();
}


void stopReflow()	{

	if ( ReflowEnable == 1 )	{
		ReflowEnable = 0;
		TempDrawEnable = 0;
		sprintf(ConsoleMSG,"STOPPED");
		Update_Page_0();
	}
}


void beepBeep()	{

	  if (BuzzerEnable == 1)	{

		  if (HAL_GPIO_ReadPin(BUZZER_GPIO_Port, BUZZER_Pin) && ((HAL_GetTick() - TimerBUZZER) > 100))	{
			  TimerBUZZER = HAL_GetTick();
			  HAL_GPIO_WritePin(BUZZER_GPIO_Port, BUZZER_Pin, 0);
		  	}

		  else if (!(HAL_GPIO_ReadPin(BUZZER_GPIO_Port, BUZZER_Pin)) && ((HAL_GetTick() - TimerBUZZER) > 100) && (beep<2))	{
			  TimerBUZZER = HAL_GetTick();
			  HAL_GPIO_WritePin(BUZZER_GPIO_Port, BUZZER_Pin, 1);
			  beep++;
		  	}
		  else	{
			  if ((HAL_GetTick() - TimerBUZZER) > 3000)	{
			 		beep=0;
			 	}
		  }
	  }

}

/* USER CODE END 0 */

/**
  * @brief  The application entry point.
  * @retval int
  */
int main(void)
{
  /* USER CODE BEGIN 1 */

	Flash_Read_Data(0x0801FC00, (uint32_t *)&ReflowParameters);

	if (!(ReflowParameters.version == config_version))	{
		ReflowParameters.firstHeatUpRate3 = 0.75;
		ReflowParameters.SoakTime3 = 100;
		ReflowParameters.SoakTempeture3 = 175;
		ReflowParameters.secondHeatUpRate3 = 1;
		ReflowParameters.ReflowTime3 = 90;
		ReflowParameters.ReflowTempeture3 = 240;
		// Lead 183C https://www.chipquik.com/datasheets/TS391AX50.pdf
		ReflowParameters.firstHeatUpRate2 = 0.75;
		ReflowParameters.SoakTime2 = 100;
		ReflowParameters.SoakTempeture2 = 150;
		ReflowParameters.secondHeatUpRate2 = 1;
		ReflowParameters.ReflowTime2 = 100;
		ReflowParameters.ReflowTempeture2 = 230;
		// Lead 148C
		ReflowParameters.firstHeatUpRate1 = 0.75;
		ReflowParameters.SoakTime1 = 100;
		ReflowParameters.SoakTempeture1 = 140;
		ReflowParameters.secondHeatUpRate1 = 1;
		ReflowParameters.ReflowTime1 = 100;
		ReflowParameters.ReflowTempeture1 = 175;
		// Lead 138C http://www.chipquik.com/datasheets/TS391LT50.pdf
		ReflowParameters.firstHeatUpRate0 = 0.75;
		ReflowParameters.SoakTime0 = 100;
		ReflowParameters.SoakTempeture0 = 130;
		ReflowParameters.secondHeatUpRate0 = 1;
		ReflowParameters.ReflowTime0 = 100;
		ReflowParameters.ReflowTempeture0 = 165;
		// Lead default (138C)
		ReflowParameters.firstHeatUpRate = 0.75;
		ReflowParameters.SoakTime = 100;
		ReflowParameters.SoakTempeture = 130;
		ReflowParameters.secondHeatUpRate = 1;
		ReflowParameters.ReflowTime = 100;
		ReflowParameters.ReflowTempeture = 165;

		ReflowParameters.KP = 85;
		ReflowParameters.Ki = 0.05;
		ReflowParameters.KD = 130;

		ReflowParameters.version = config_version;
		SaveReflowParameters();
	}

	calculateReflowCurve();

	PID.Kp = ReflowParameters.KP;
	PID.Ki = ReflowParameters.Ki;
	PID.Kd = ReflowParameters.KD;

	arm_pid_init_f32(&PID, 1);
	beep=0;
  /* USER CODE END 1 */

  /* MCU Configuration--------------------------------------------------------*/

  /* Reset of all peripherals, Initializes the Flash interface and the Systick. */
  HAL_Init();

  /* Configure the system clock */
  SystemClock_Config();

  /* Initialize all configured peripherals */
  MX_GPIO_Init();
  MX_SPI1_Init();
  MX_TIM4_Init();
  MX_TIM1_Init();
  MX_USART1_UART_Init();
  /* USER CODE BEGIN 2 */
  TimerBUZZER = HAL_GetTick();
  TimerGui = HAL_GetTick();

  HAL_TIM_Base_Start_IT(&htim4);
  HAL_TIM_PWM_Start(&htim1, TIM_CHANNEL_1);

  htim1.Instance->CCR1 = 10;

  //startReflow();
  HAL_Delay(2000);
  HAL_UART_Receive_IT(&huart1, UART_Recieved_Data, 5);
  sprintf(ConsoleMSG,"IDLE");
  Update_Page_0();
  Draw_Reflow_Curve();
  HAL_UART_Receive_IT(&huart1, UART_Recieved_Data, 5);

  /* USER CODE END 2 */

  /* Infinite loop */
  /* USER CODE BEGIN WHILE */
  while (1)
  {
    /* USER CODE END WHILE */

    /* USER CODE BEGIN 3 */

	  if (HAL_GetTick() - TimerGui > 505)	{
		  TimerGui = HAL_GetTick();
		  HandleGui();
	  	}
		if ((ReflowEnable == 1) && (ReflowIndex == PhaseIndex[4])) {
			BuzzerEnable = 1;
		}

	  beepBeep();

  }
}
  /* USER CODE END 3 */


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
