polihedron/DIY-Reflow-Oven/reflow oven stm32/Core/Inc/main.h

#define CS_Pin GPIO_PIN_4
#define CS_GPIO_Port GPIOA
#define BUZZER_Pin GPIO_PIN_15
#define BUZZER_GPIO_Port GPIOA
