polihedron/DIY-Reflow-Oven/(commit log)

2021-07-03 buzzer to PA15, 4 reflow profiles, fixed compilation warnings, added temperature filter.
    [FLASH_PAGE.h, FlASH_PAGE.c, Reflow_Oven_STM32.ioc, main.c, main.h]
2021-09-05 UI - current temp and chart change, input limits.
2021-10-03 switch from debug to release
2021-12-05 fix for issue #5, cfg. version display in adv. menu.
    [main.c]
2021-12-06 version check and temperature readings fix, firmware version info
    [main.c]
2021-12-06 amount of parameters to save in flash correction
    [main.c]
